Tsukigake/RCAP2021/README.md

# RCAP2021
RCAP 2021 TDP

英語はgoolgle翻訳です。
