Tsukigake/RCAP2021/(list of files, cad)

Other CAD files:
motor unite left v17.f3z
